go4retro/Nu6509/ref/6502 $B1.JPG

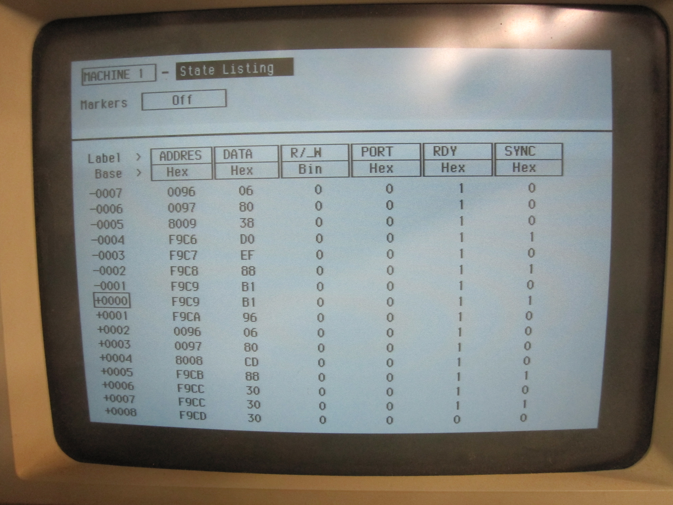
ref/6502 $B1.JPG
