go4retro/Nu6509/ref/65C02 $91.JPG

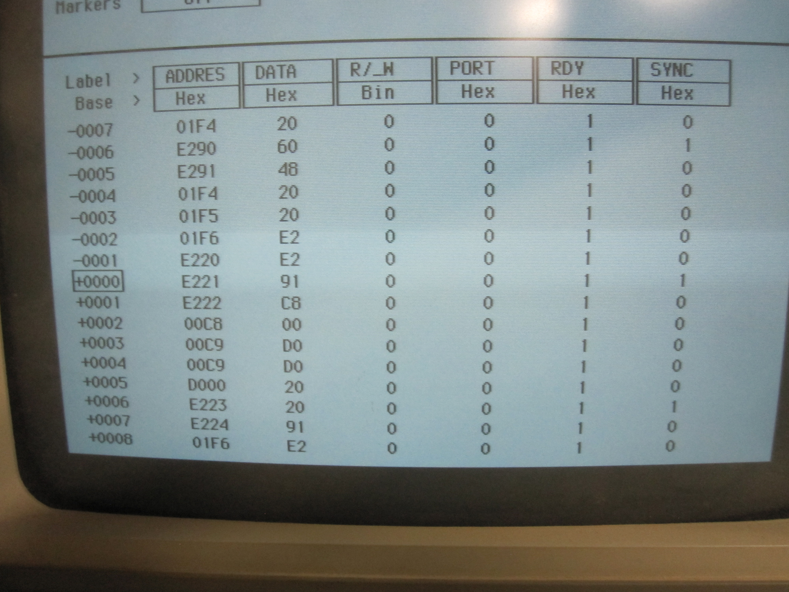
ref/65C02 $91.JPG
