go4retro/Nu6509/pcb/Nu6509 PCB v4.png

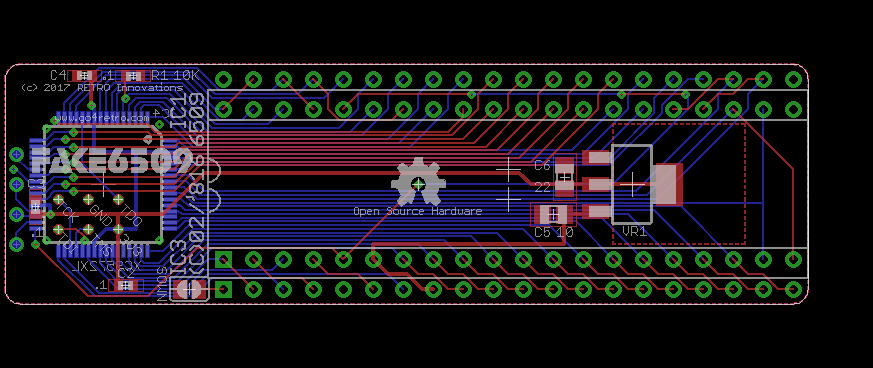
pcb/Nu6509 PCB v4.png
