go4retro/Nu6509/pcb/Nu6509_v3 PCB.png

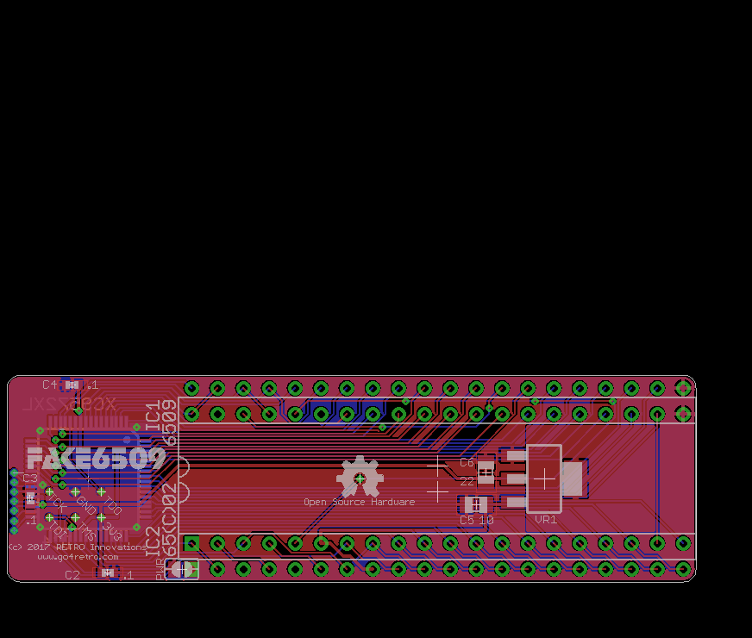
pcb/Nu6509_v3 PCB.png
