go4retro/Nu6509/pcb/Nu6509_v3 Schematic.png

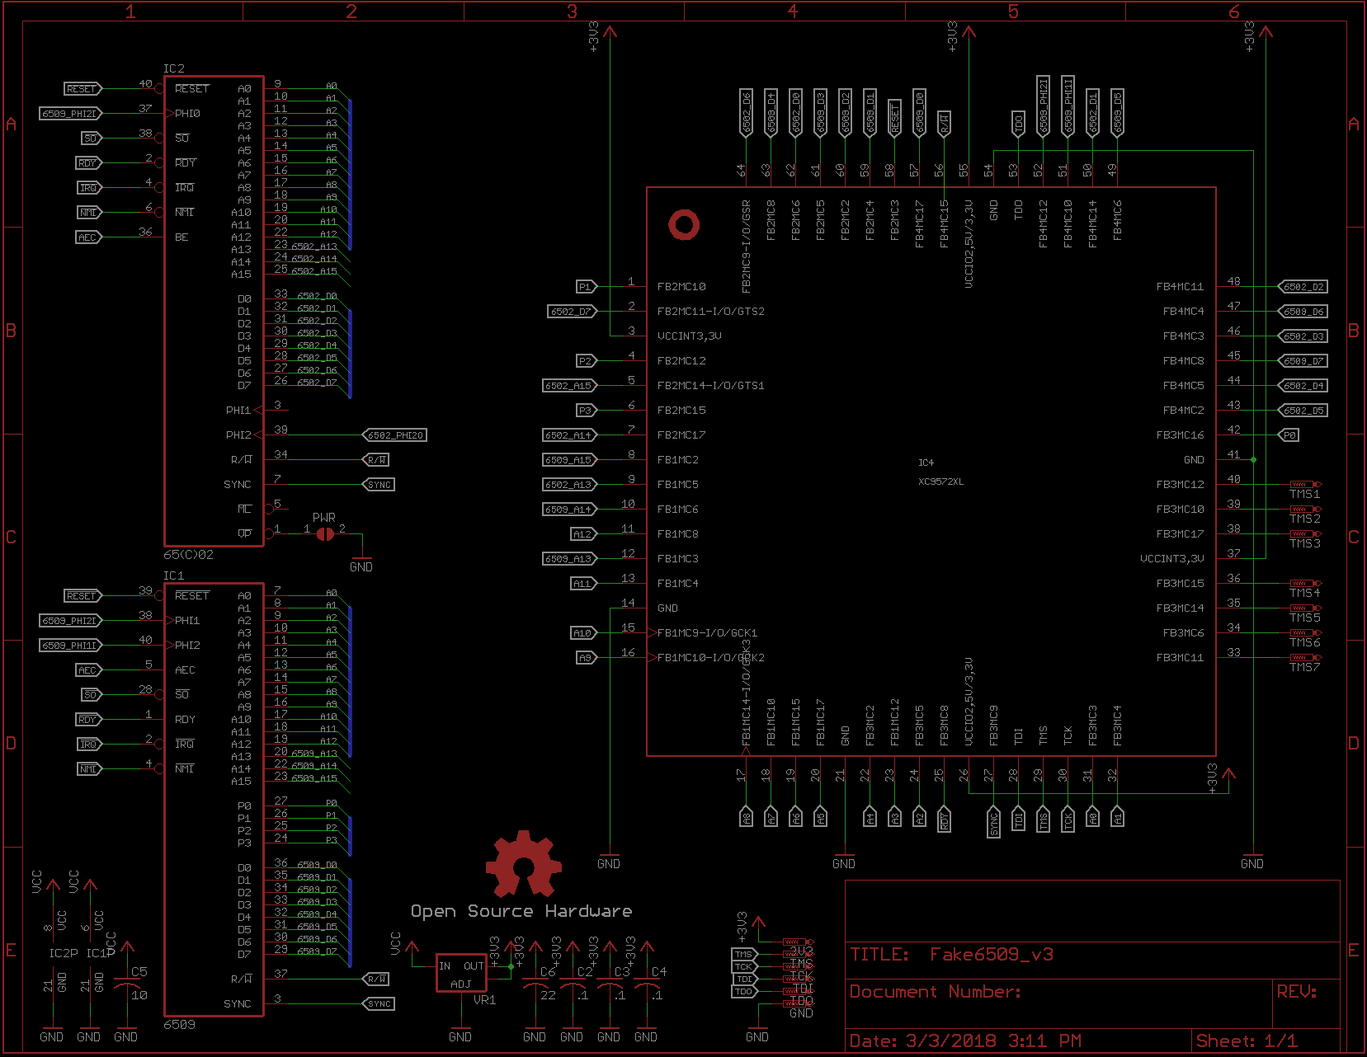
pcb/Nu6509_v3 Schematic.png
