go4retro/Nu6509/ref/65C02 $B1.JPG

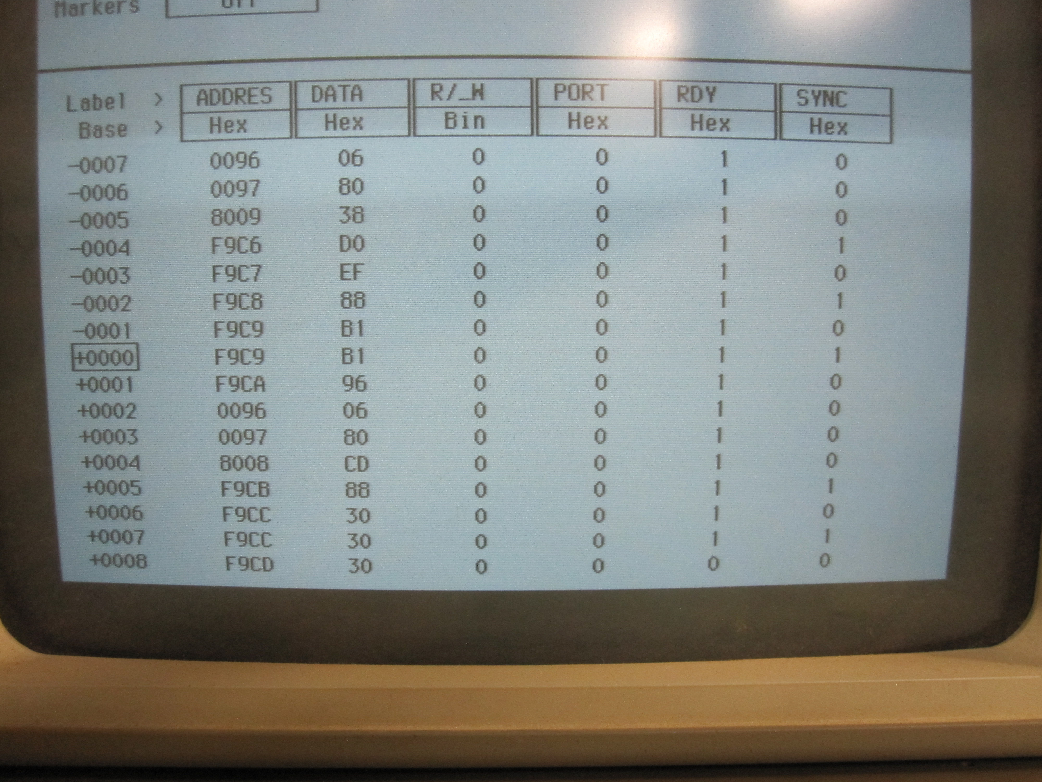
ref/65C02 $B1.JPG
