go4retro/Nu6509/pcb/Nu6509_v3 Schematic.pdf

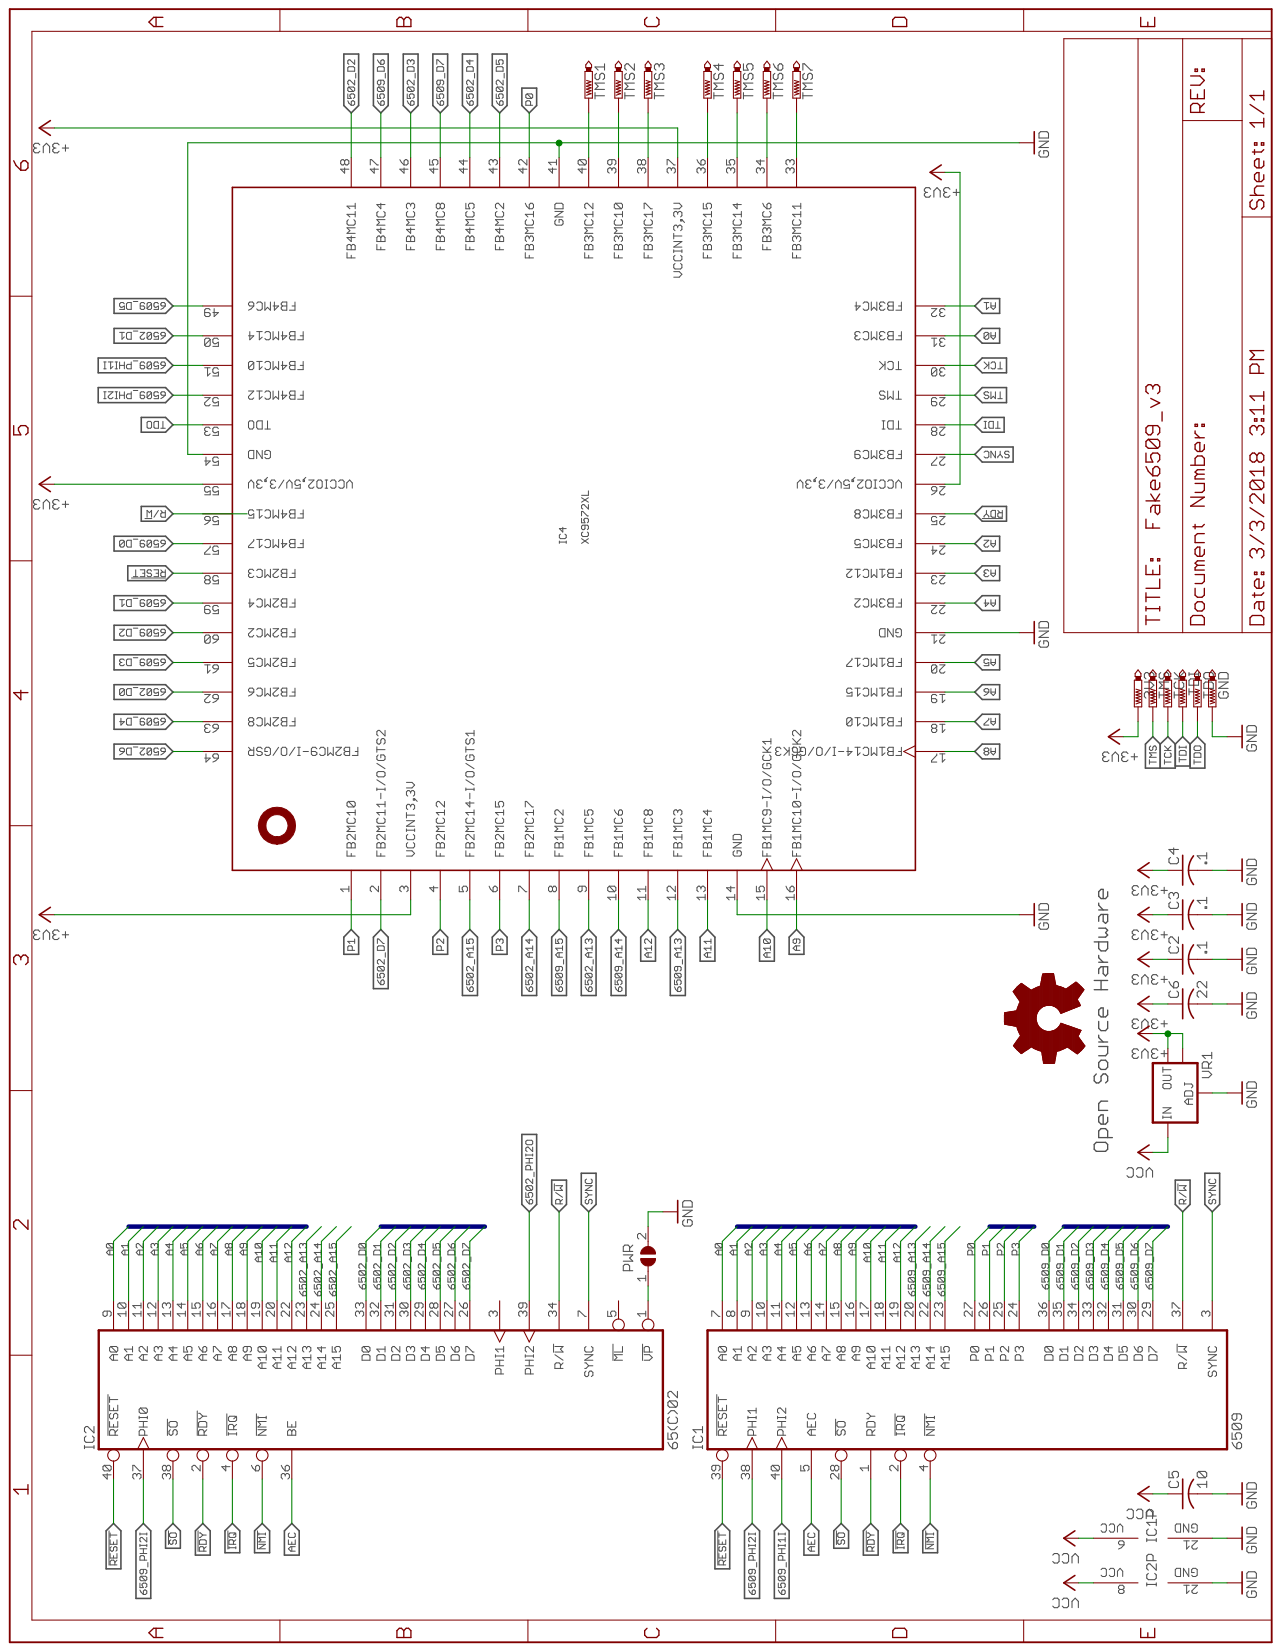
[picture p7: page 1]
