go4retro/Nu6509/pcb/Nu6509_v3 PCB.pdf

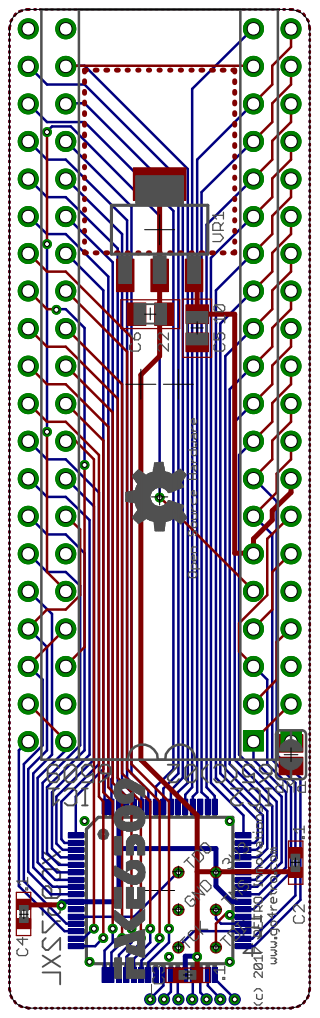
[picture p8: page 1]
