go4retro/Nu6509/pcb/Nu6509_v2 Schematic.pdf

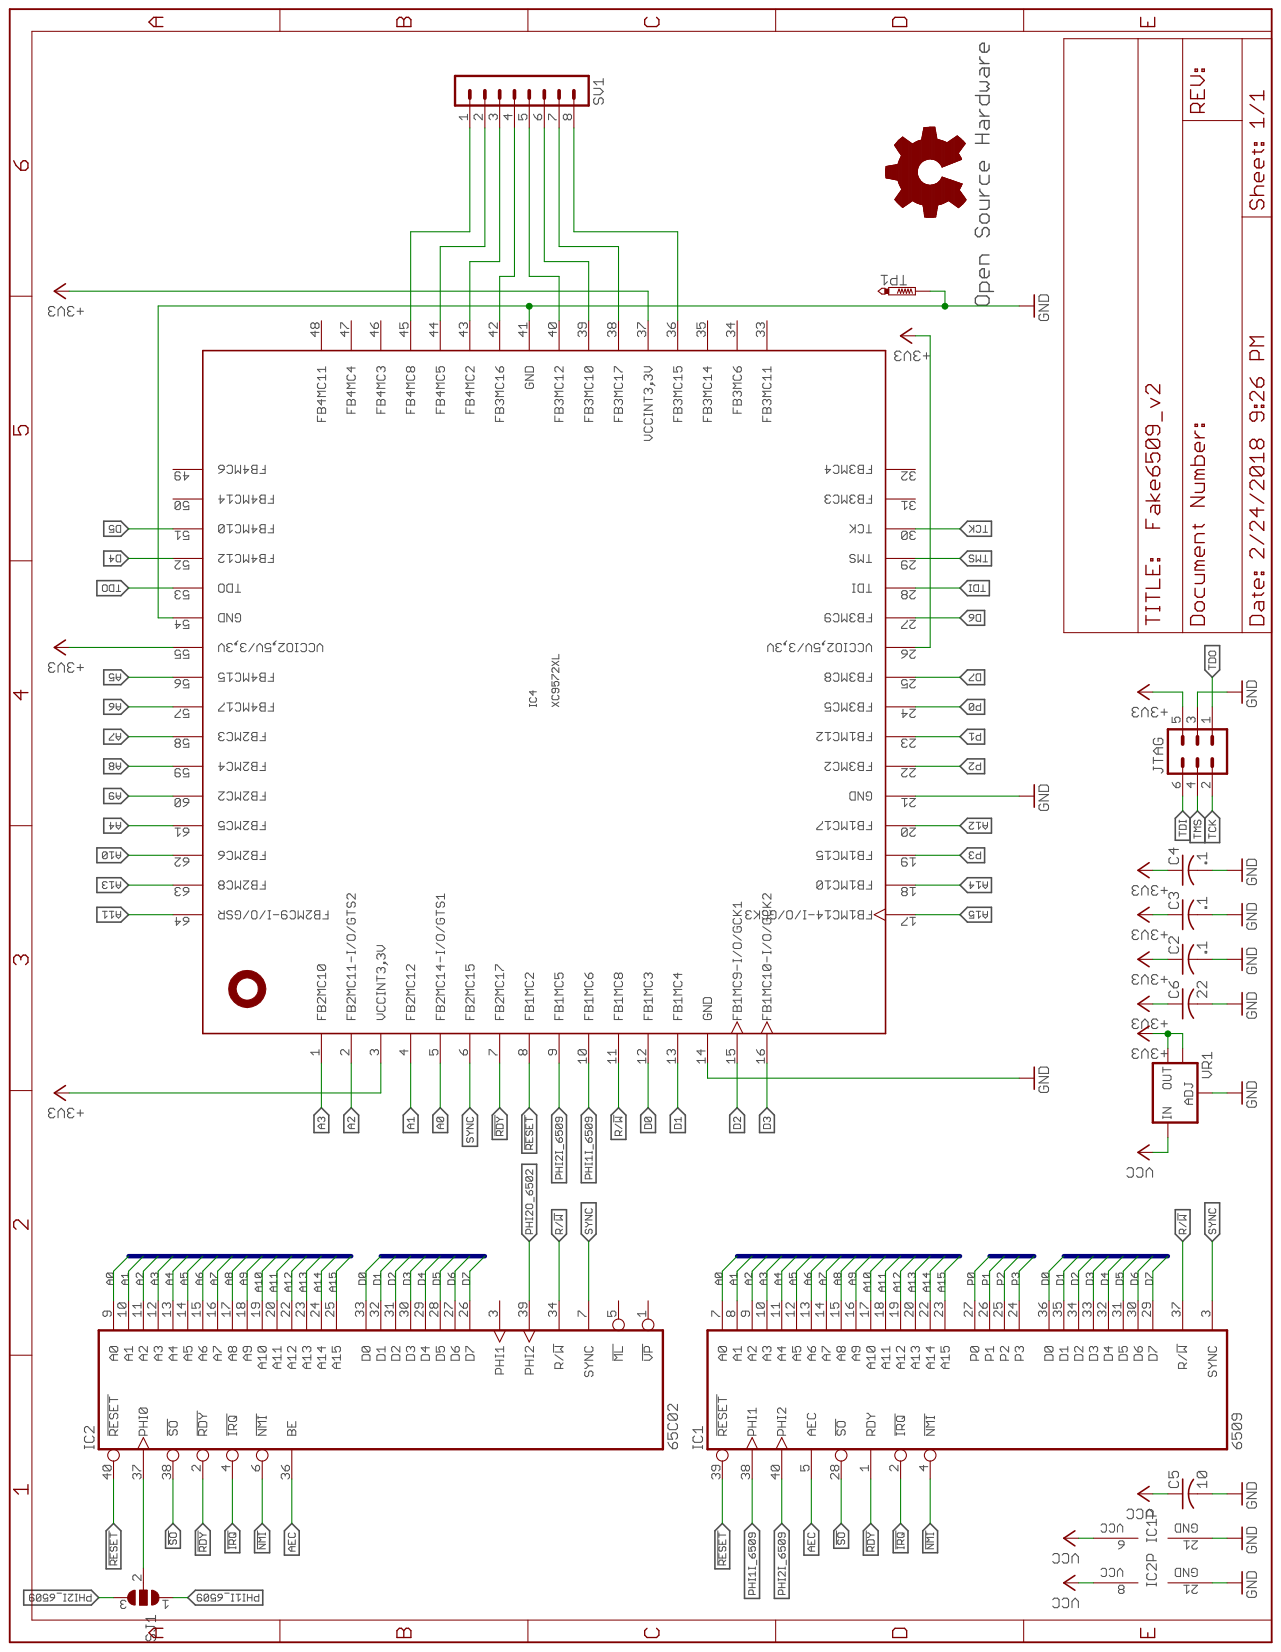
[picture p9: page 1]
