go4retro/Nu6509/pcb/Nu6509_v2 PCB.pdf

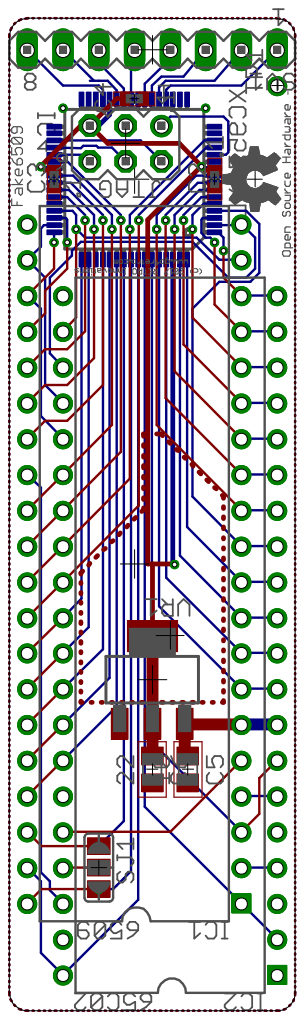
[picture p10: page 1]
