go4retro/Nu6509/pcb/Nu6509_v4.brd

## EAGLE design pcb/Nu6509_v4.brd (2020-04-17)

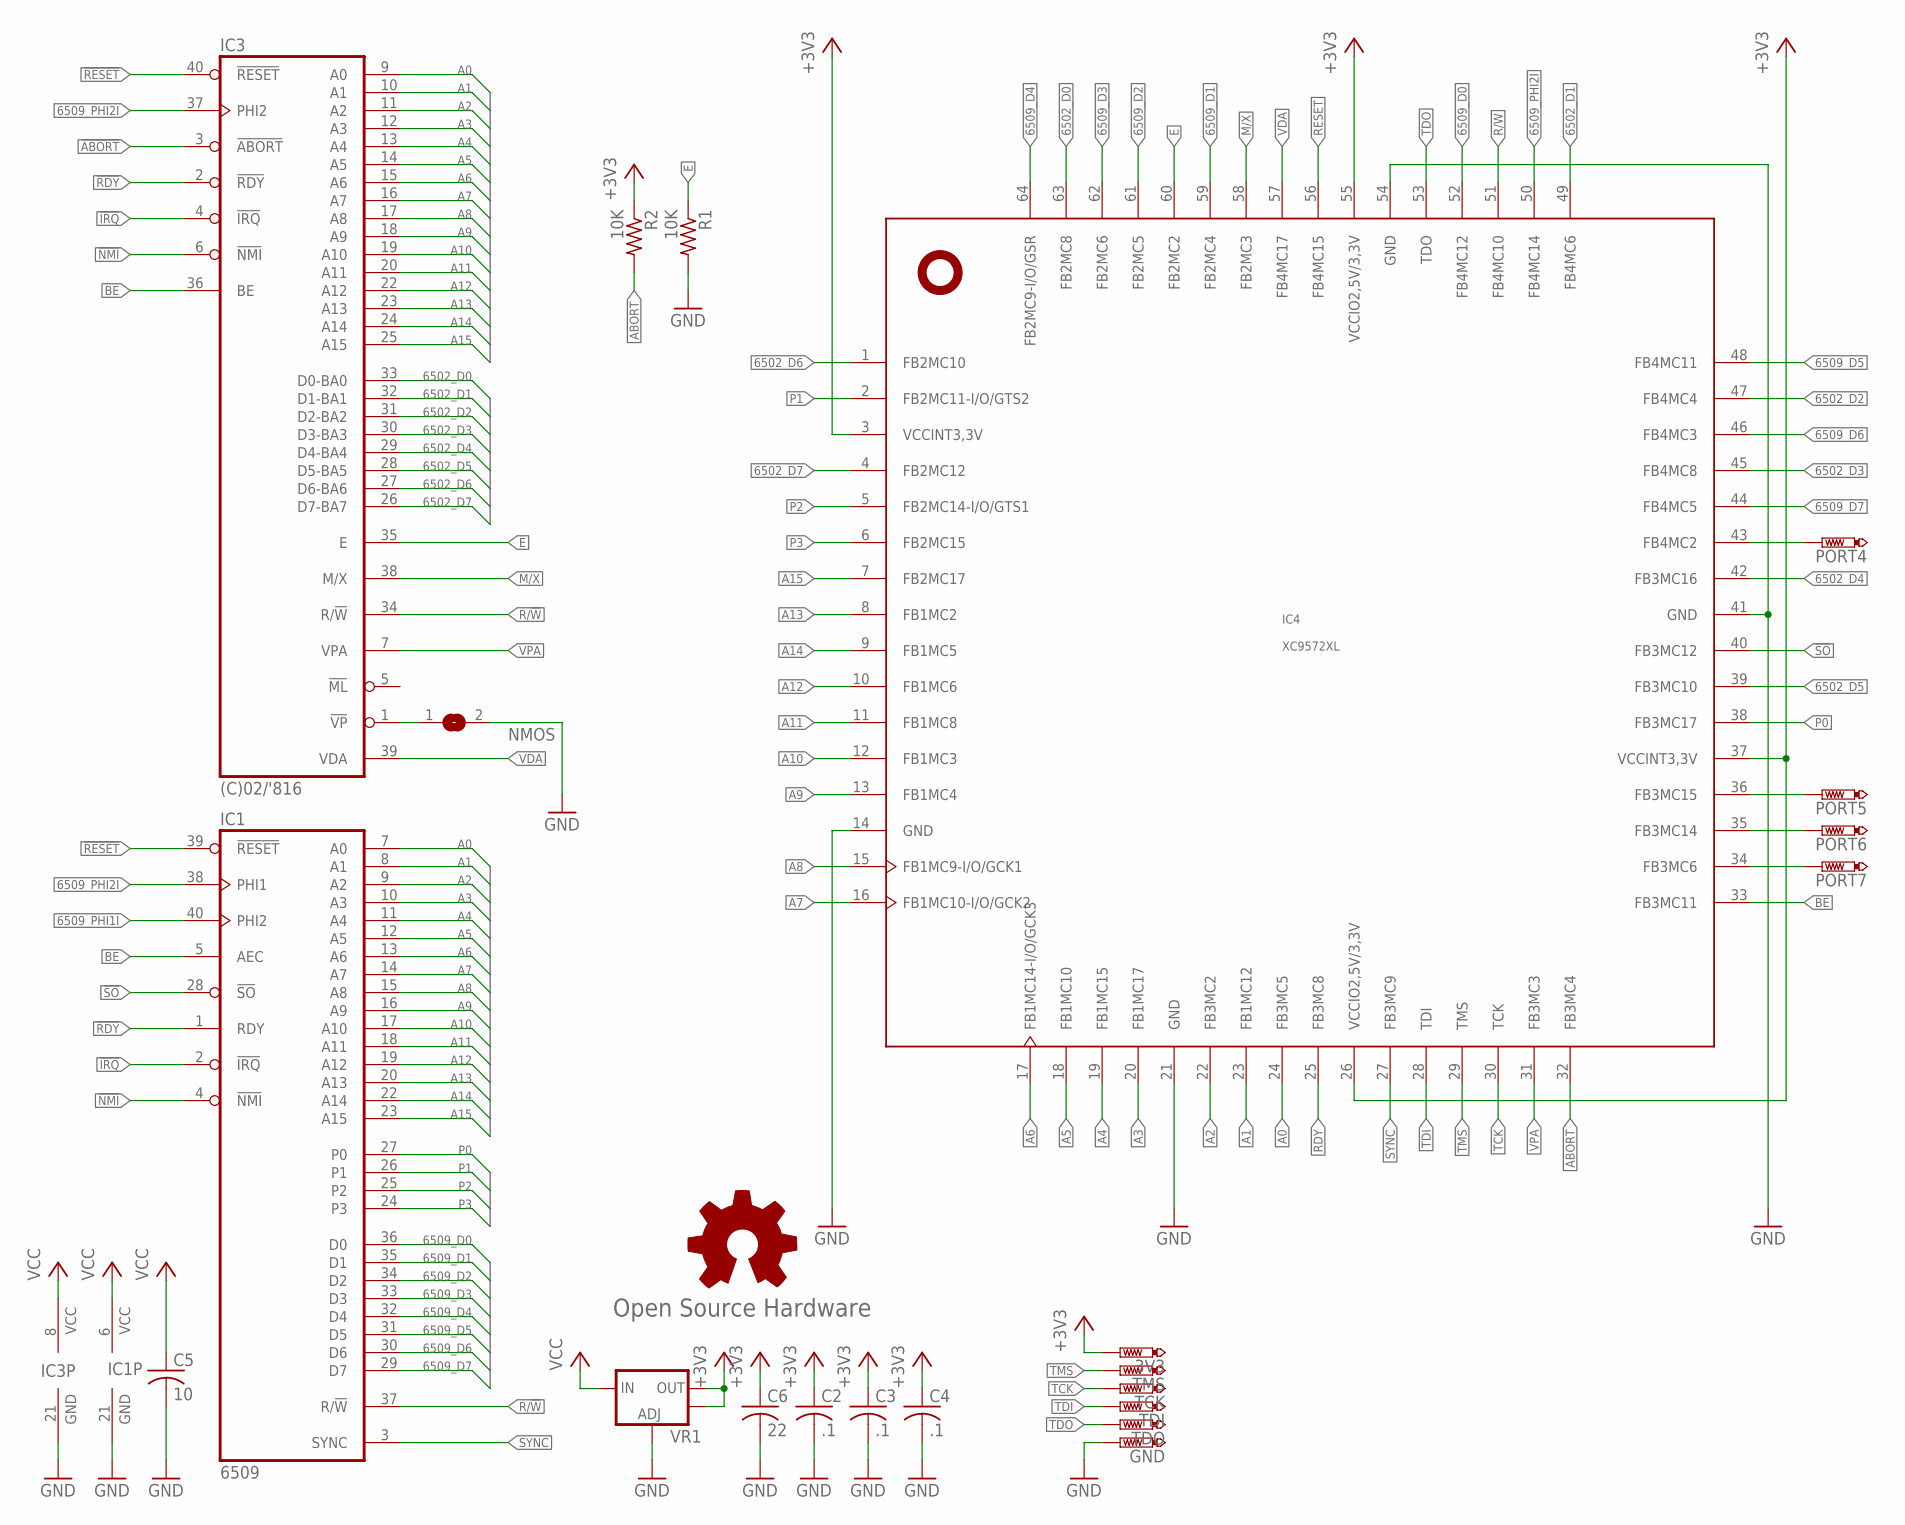
[picture p11: schematic Nu6509_v4.sch]

Parts:
3V3: PTR1TP08R; TP08R
C2, C3, C4: .1; C0402
C5: 10; C0805
C6: 22; C0805
GND: PTR1TP08R; TP08R
GOLD_ORB_SM1: Open Source Hardware; OSHW_5MM
IC1: 6509; DIL40-ROUNDPAD
IC3: (C)02/'816; DIL40-ROUNDPAD
IC4: XC9572XL; VQFP64
NMOS: SJ
PORT4, PORT5, PORT6, PORT7: PTR1TP08R; TP08R
R1, R2: 10K; R0402
TCK: PTR1TP08R; TP08R
TDI: PTR1TP08R; TP08R
TDO: PTR1TP08R; TP08R
TMS: PTR1TP08R; TP08R
VR1: V_REG_LM1117SOT223; SOT223

Connections:
6502_D0: IC3.33 (D0-BA0), IC4.63 (FB2MC8)
6502_D1: IC3.32 (D1-BA1), IC4.49 (FB4MC6)
6502_D2: IC3.31 (D2-BA2), IC4.47 (FB4MC4)
6502_D3: IC3.30 (D3-BA3), IC4.45 (FB4MC8)
6502_D4: IC3.29 (D4-BA4), IC4.42 (FB3MC16)
6502_D5: IC3.28 (D5-BA5), IC4.39 (FB3MC10)
6502_D6: IC3.27 (D6-BA6), IC4.1 (FB2MC10)
6502_D7: IC3.26 (D7-BA7), IC4.4 (FB2MC12)
6509_D0: IC1.36 (D0), IC4.52 (FB4MC12)
6509_D1: IC1.35 (D1), IC4.59 (FB2MC4)
6509_D2: IC1.34 (D2), IC4.61 (FB2MC5)
6509_D3: IC1.33 (D3), IC4.62 (FB2MC6)
6509_D4: IC1.32 (D4), IC4.64 (FB2MC9-I/O/GSR)
6509_D5: IC1.31 (D5), IC4.48 (FB4MC11)
6509_D6: IC1.30 (D6), IC4.46 (FB4MC3)
6509_D7: IC1.29 (D7), IC4.44 (FB4MC5)
6509_PHI1I: IC1.40 (PHI2)
6509_PHI2I: IC1.38 (PHI1), IC3.37 (PHI2), IC4.50 (FB4MC14)
!ABORT: IC3.3 (!ABORT), IC4.32 (FB3MC4), R2.2
!IRQ: IC1.2 (!IRQ), IC3.4 (!IRQ)
!NMI: IC1.4 (!NMI), IC3.6 (!NMI)
!RDY: IC1.1 (RDY), IC3.2 (!RDY), IC4.25 (FB3MC8)
!RESET: IC1.39 (!RESET), IC3.40 (!RESET), IC4.56 (FB4MC15)
!SO: IC1.28 (!SO), IC4.40 (FB3MC12)
+3V3: 3V3.TP, C2.1, C3.1, C4.1, C6.1, IC4.3 (VCCINT3,3V), IC4.26 (VCCIO2,5V/3,3V), IC4.37 (VCCINT3,3V), IC4.55 (VCCIO2,5V/3,3V), R2.1, VR1.2 (OUT), VR1.4 (OUT)
A0: IC1.7 (A0), IC3.9 (A0), IC4.24 (FB3MC5)
A1: IC1.8 (A1), IC3.10 (A1), IC4.23 (FB1MC12)
A2: IC1.9 (A2), IC3.11 (A2), IC4.22 (FB3MC2)
A3: IC1.10 (A3), IC3.12 (A3), IC4.20 (FB1MC17)
A4: IC1.11 (A4), IC3.13 (A4), IC4.19 (FB1MC15)
A5: IC1.12 (A5), IC3.14 (A5), IC4.18 (FB1MC10)
A6: IC1.13 (A6), IC3.15 (A6), IC4.17 (FB1MC14-I/O/GCK3)
A7: IC1.14 (A7), IC3.16 (A7), IC4.16 (FB1MC10-I/O/GCK2)
A8: IC1.15 (A8), IC3.17 (A8), IC4.15 (FB1MC9-I/O/GCK1)
A9: IC1.16 (A9), IC3.18 (A9), IC4.13 (FB1MC4)
A10: IC1.17 (A10), IC3.19 (A10), IC4.12 (FB1MC3)
A11: IC1.18 (A11), IC3.20 (A11), IC4.11 (FB1MC8)
A12: IC1.19 (A12), IC3.22 (A12), IC4.10 (FB1MC6)
A13: IC1.20 (A13), IC3.23 (A13), IC4.8 (FB1MC2)
A14: IC1.22 (A14), IC3.24 (A14), IC4.9 (FB1MC5)
A15: IC1.23 (A15), IC3.25 (A15), IC4.7 (FB2MC17)
BE: IC1.5 (AEC), IC3.36 (BE), IC4.33 (FB3MC11)
E: IC3.35 (E), IC4.60 (FB2MC2), R1.1
GND: C2.2, C3.2, C4.2, C5.2, C6.2, GND.TP, IC1.21 (GND), IC3.21 (GND), IC4.14 (GND), IC4.21 (GND), IC4.41 (GND), IC4.54 (GND), NMOS.2, R1.2, VR1.1 (ADJ)
M/X: IC3.38 (M/X), IC4.58 (FB2MC3)
unnamed: IC3.1 (!VP), NMOS.1
P0: IC1.27 (P0), IC4.38 (FB3MC17)
P1: IC1.26 (P1), IC4.2 (FB2MC11-I/O/GTS2)
P2: IC1.25 (P2), IC4.5 (FB2MC14-I/O/GTS1)
P3: IC1.24 (P3), IC4.6 (FB2MC15)
PORT4: IC4.43 (FB4MC2), PORT4.TP
PORT5: IC4.36 (FB3MC15), PORT5.TP
PORT6: IC4.35 (FB3MC14), PORT6.TP
PORT7: IC4.34 (FB3MC6), PORT7.TP
R/!W: IC1.37 (R/!W), IC3.34 (R/!W), IC4.51 (FB4MC10)
SYNC: IC1.3 (SYNC), IC4.27 (FB3MC9)
TCK: IC4.30 (TCK), TCK.TP
TDI: IC4.28 (TDI), TDI.TP
TDO: IC4.53 (TDO), TDO.TP
TMS: IC4.29 (TMS), TMS.TP
VCC: C5.1, IC1.6 (VCC), IC3.8 (VCC), VR1.3 (IN)
VDA: IC3.39 (VDA), IC4.57 (FB4MC17)
VPA: IC3.7 (VPA), IC4.31 (FB3MC3)

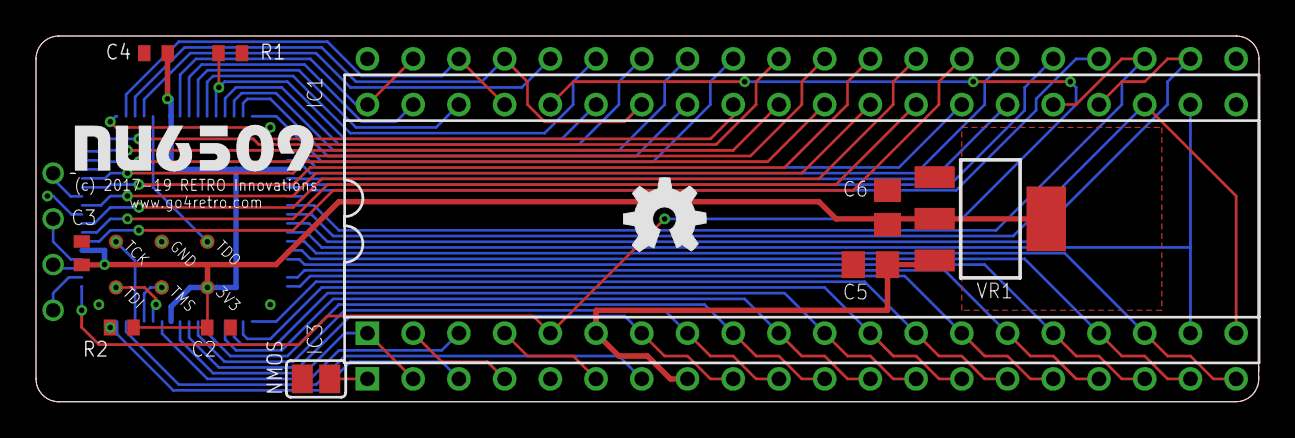
[picture p12: board Nu6509_v4.brd from above]

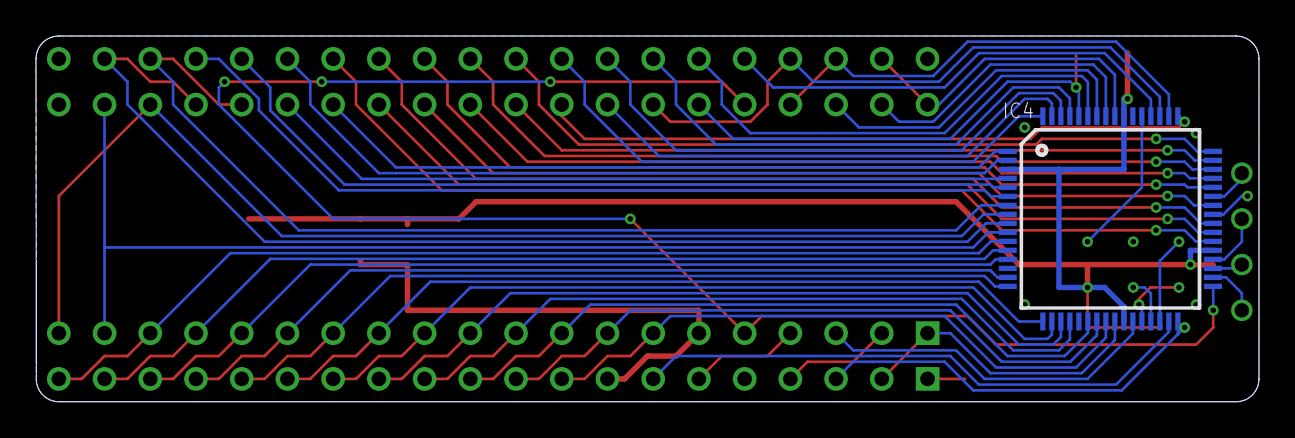
[picture p13: board Nu6509_v4.brd from below]

Board: 2 copper layers, 67.9 x 20.3 mm, 23 parts (5 on the bottom side), 62 nets.
