go4retro/Nu6509/pcb/Nu6509_v3.brd

## EAGLE design pcb/Nu6509_v3.brd (2018-07-28, an earlier design)

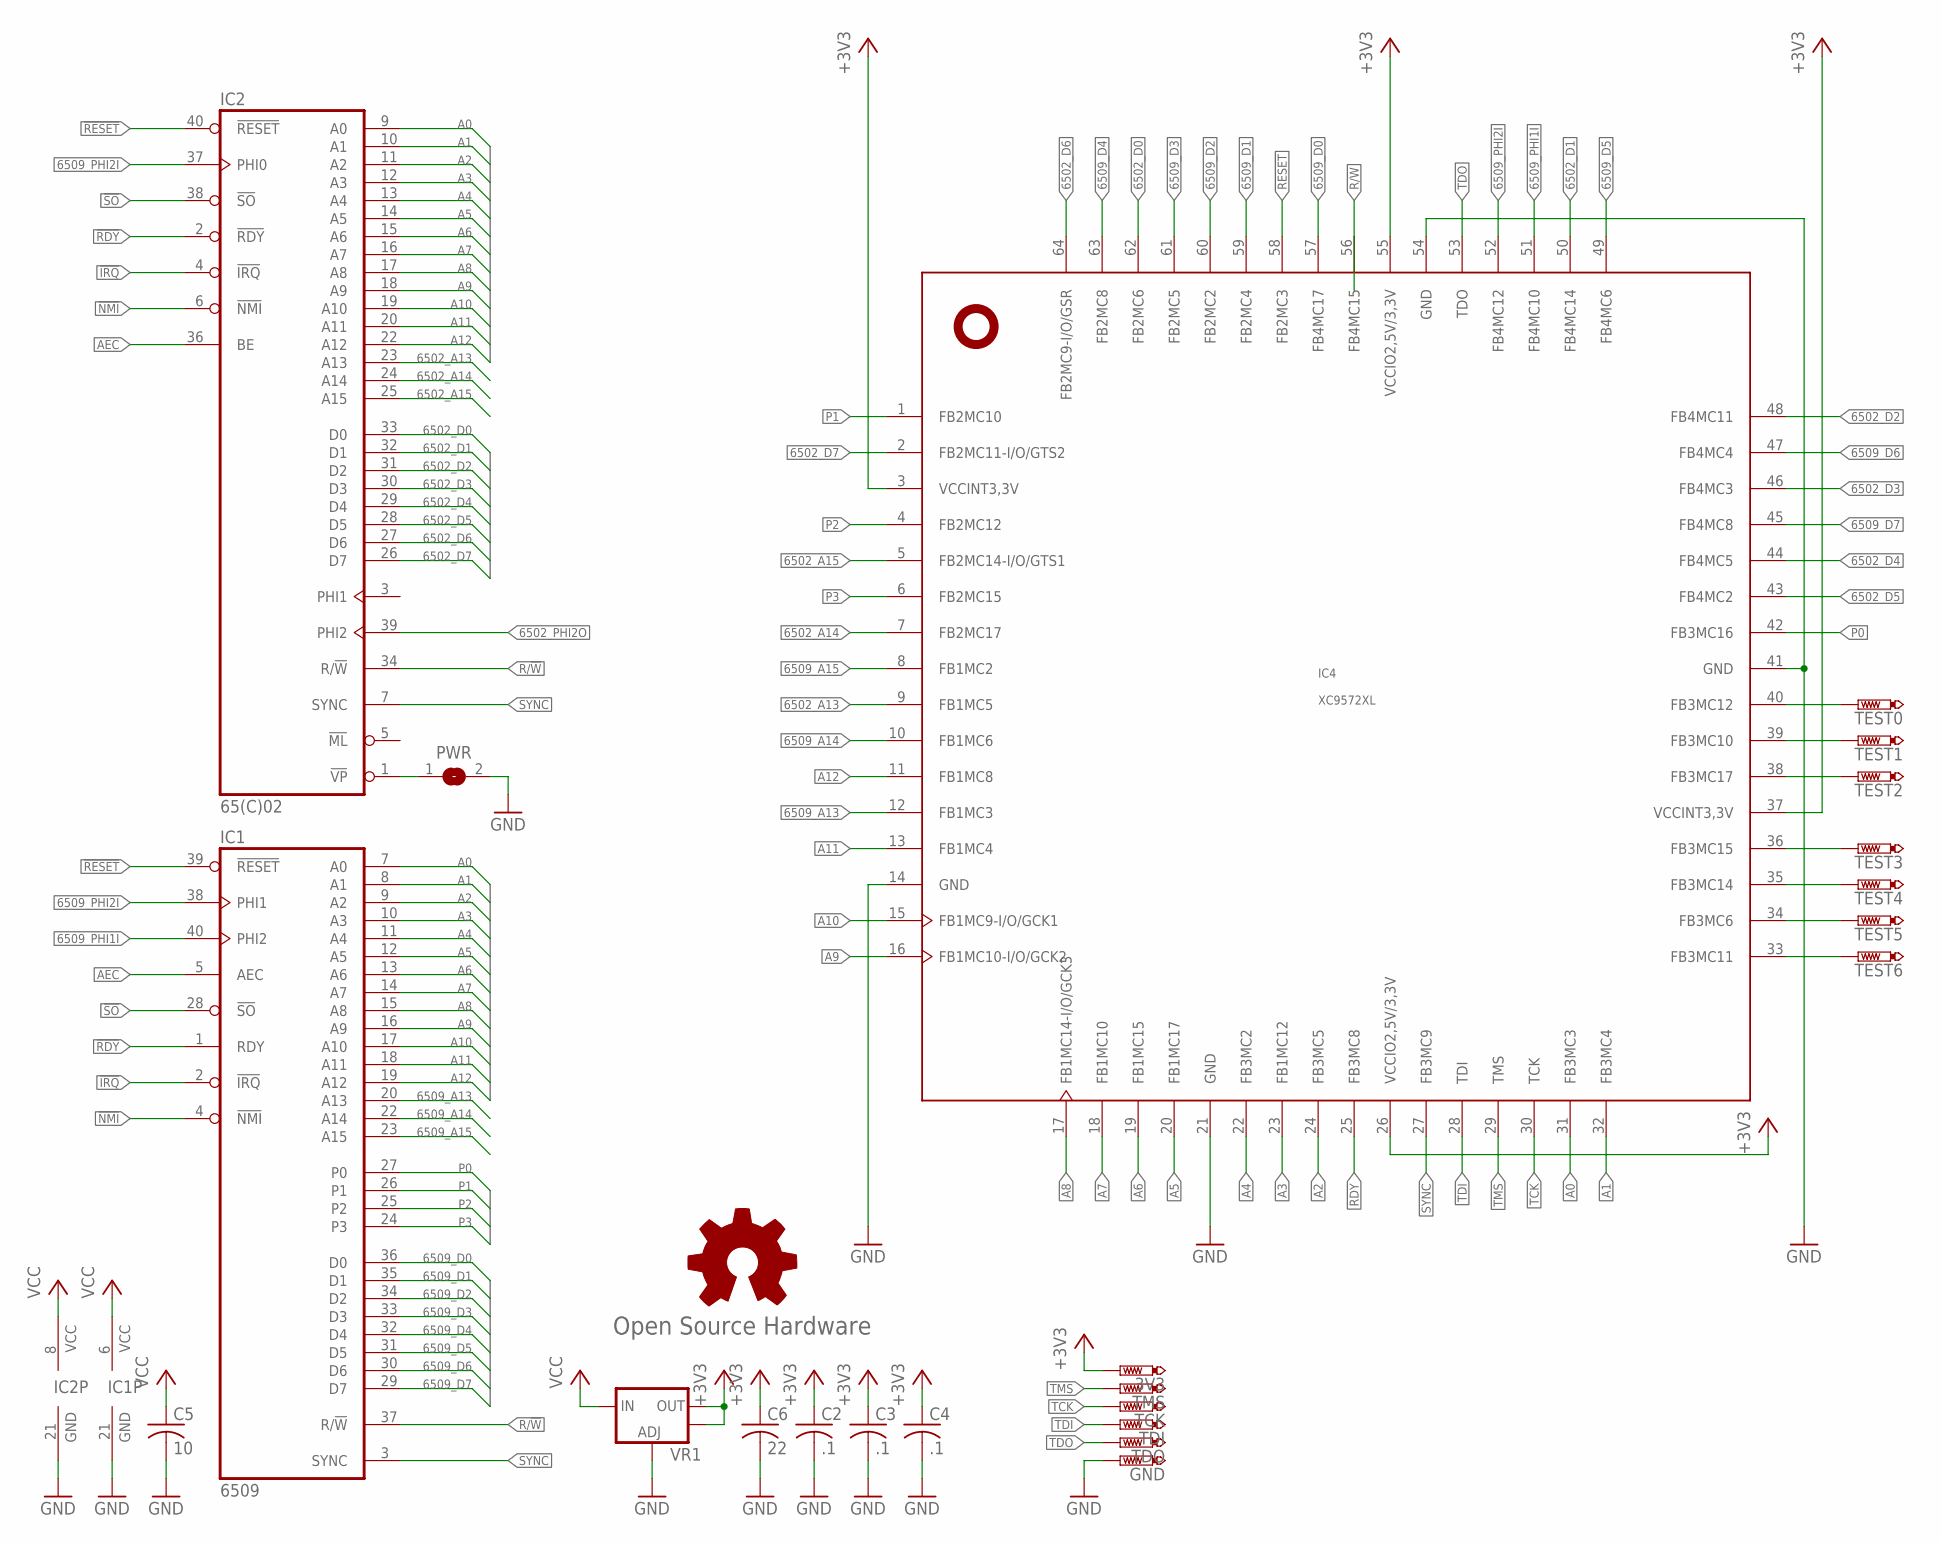
[picture p14: schematic Nu6509_v3.sch]

Parts:
3V3: PTR1TP08R; TP08R
C2, C3, C4: .1; C0402
C5: 10; C0805
C6: 22; C0805
GND: PTR1TP08R; TP08R
GOLD_ORB_SM1: Open Source Hardware; OSHW_5MM
IC1: 6509; DIL40-ROUNDPAD
IC2: 65(C)02; DIL40-ROUNDPAD
IC4: XC9572XL; VQFP64
PWR: SJ
TCK: PTR1TP08R; TP08R
TDI: PTR1TP08R; TP08R
TDO: PTR1TP08R; TP08R
TEST0, TEST1, TEST2, TEST3, TEST4, TEST5, TEST6: PTR1TP08R; TP08R
TMS: PTR1TP08R; TP08R
VR1: V_REG_LM1117SOT223; SOT223

Connections:
6502_A13: IC2.23 (A13), IC4.9 (FB1MC5)
6502_A14: IC2.24 (A14), IC4.7 (FB2MC17)
6502_A15: IC2.25 (A15), IC4.5 (FB2MC14-I/O/GTS1)
6502_D0: IC2.33 (D0), IC4.62 (FB2MC6)
6502_D1: IC2.32 (D1), IC4.50 (FB4MC14)
6502_D2: IC2.31 (D2), IC4.48 (FB4MC11)
6502_D3: IC2.30 (D3), IC4.46 (FB4MC3)
6502_D4: IC2.29 (D4), IC4.44 (FB4MC5)
6502_D5: IC2.28 (D5), IC4.43 (FB4MC2)
6502_D6: IC2.27 (D6), IC4.64 (FB2MC9-I/O/GSR)
6502_D7: IC2.26 (D7), IC4.2 (FB2MC11-I/O/GTS2)
6502_PHI2O: IC2.39 (PHI2)
6509_A13: IC1.20 (A13), IC4.12 (FB1MC3)
6509_A14: IC1.22 (A14), IC4.10 (FB1MC6)
6509_A15: IC1.23 (A15), IC4.8 (FB1MC2)
6509_D0: IC1.36 (D0), IC4.57 (FB4MC17)
6509_D1: IC1.35 (D1), IC4.59 (FB2MC4)
6509_D2: IC1.34 (D2), IC4.60 (FB2MC2)
6509_D3: IC1.33 (D3), IC4.61 (FB2MC5)
6509_D4: IC1.32 (D4), IC4.63 (FB2MC8)
6509_D5: IC1.31 (D5), IC4.49 (FB4MC6)
6509_D6: IC1.30 (D6), IC4.47 (FB4MC4)
6509_D7: IC1.29 (D7), IC4.45 (FB4MC8)
6509_PHI1I: IC1.40 (PHI2), IC4.51 (FB4MC10)
6509_PHI2I: IC1.38 (PHI1), IC2.37 (PHI0), IC4.52 (FB4MC12)
!IRQ: IC1.2 (!IRQ), IC2.4 (!IRQ)
!NMI: IC1.4 (!NMI), IC2.6 (!NMI)
!RDY: IC1.1 (RDY), IC2.2 (!RDY), IC4.25 (FB3MC8)
!RESET: IC1.39 (!RESET), IC2.40 (!RESET), IC4.58 (FB2MC3)
!SO: IC1.28 (!SO), IC2.38 (!SO)
+3V3: 3V3.TP, C2.1, C3.1, C4.1, C6.1, IC4.3 (VCCINT3,3V), IC4.26 (VCCIO2,5V/3,3V), IC4.37 (VCCINT3,3V), IC4.55 (VCCIO2,5V/3,3V), VR1.2 (OUT), VR1.4 (OUT)
A0: IC1.7 (A0), IC2.9 (A0), IC4.31 (FB3MC3)
A1: IC1.8 (A1), IC2.10 (A1), IC4.32 (FB3MC4)
A2: IC1.9 (A2), IC2.11 (A2), IC4.24 (FB3MC5)
A3: IC1.10 (A3), IC2.12 (A3), IC4.23 (FB1MC12)
A4: IC1.11 (A4), IC2.13 (A4), IC4.22 (FB3MC2)
A5: IC1.12 (A5), IC2.14 (A5), IC4.20 (FB1MC17)
A6: IC1.13 (A6), IC2.15 (A6), IC4.19 (FB1MC15)
A7: IC1.14 (A7), IC2.16 (A7), IC4.18 (FB1MC10)
A8: IC1.15 (A8), IC2.17 (A8), IC4.17 (FB1MC14-I/O/GCK3)
A9: IC1.16 (A9), IC2.18 (A9), IC4.16 (FB1MC10-I/O/GCK2)
A10: IC1.17 (A10), IC2.19 (A10), IC4.15 (FB1MC9-I/O/GCK1)
A11: IC1.18 (A11), IC2.20 (A11), IC4.13 (FB1MC4)
A12: IC1.19 (A12), IC2.22 (A12), IC4.11 (FB1MC8)
AEC: IC1.5 (AEC), IC2.36 (BE)
GND: C2.2, C3.2, C4.2, C5.2, C6.2, GND.TP, IC1.21 (GND), IC2.21 (GND), IC4.14 (GND), IC4.21 (GND), IC4.41 (GND), IC4.54 (GND), PWR.2, VR1.1 (ADJ)
unnamed: IC2.1 (!VP), PWR.1
P0: IC1.27 (P0), IC4.42 (FB3MC16)
P1: IC1.26 (P1), IC4.1 (FB2MC10)
P2: IC1.25 (P2), IC4.4 (FB2MC12)
P3: IC1.24 (P3), IC4.6 (FB2MC15)
R/!W: IC1.37 (R/!W), IC2.34 (R/!W), IC4.56 (FB4MC15)
SYNC: IC1.3 (SYNC), IC2.7 (SYNC), IC4.27 (FB3MC9)
TCK: IC4.30 (TCK), TCK.TP
TDI: IC4.28 (TDI), TDI.TP
TDO: IC4.53 (TDO), TDO.TP
TEST0: IC4.40 (FB3MC12), TEST0.TP
TEST1: IC4.39 (FB3MC10), TEST1.TP
TEST2: IC4.38 (FB3MC17), TEST2.TP
TEST3: IC4.36 (FB3MC15), TEST3.TP
TEST4: IC4.35 (FB3MC14), TEST4.TP
TEST5: IC4.34 (FB3MC6), TEST5.TP
TEST6: IC4.33 (FB3MC11), TEST6.TP
TMS: IC4.29 (TMS), TMS.TP
VCC: C5.1, IC1.6 (VCC), IC2.8 (VCC), VR1.3 (IN)

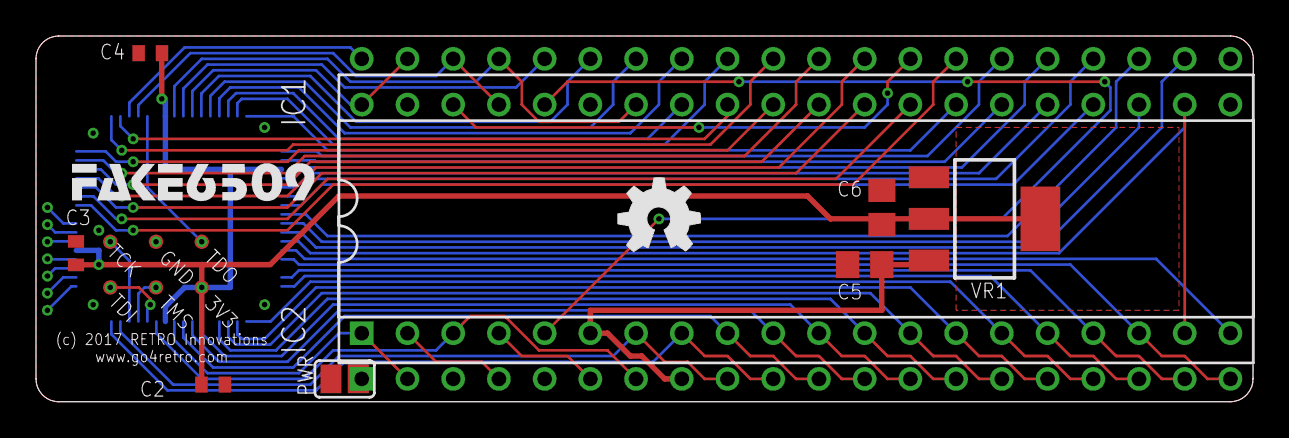
[picture p15: board Nu6509_v3.brd from above]

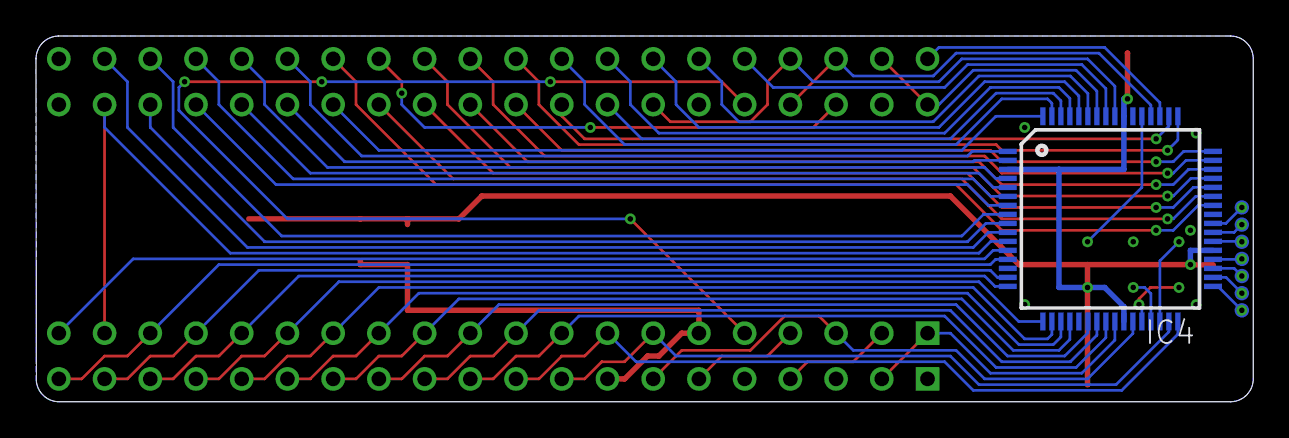
[picture p16: board Nu6509_v3.brd from below]

Board: 2 copper layers, 67.6 x 20.3 mm, 24 parts (8 on the bottom side), 64 nets.
