go4retro/Nu6509/pcb/Nu6509_test.brd

## EAGLE design pcb/Nu6509_test.brd (continued)

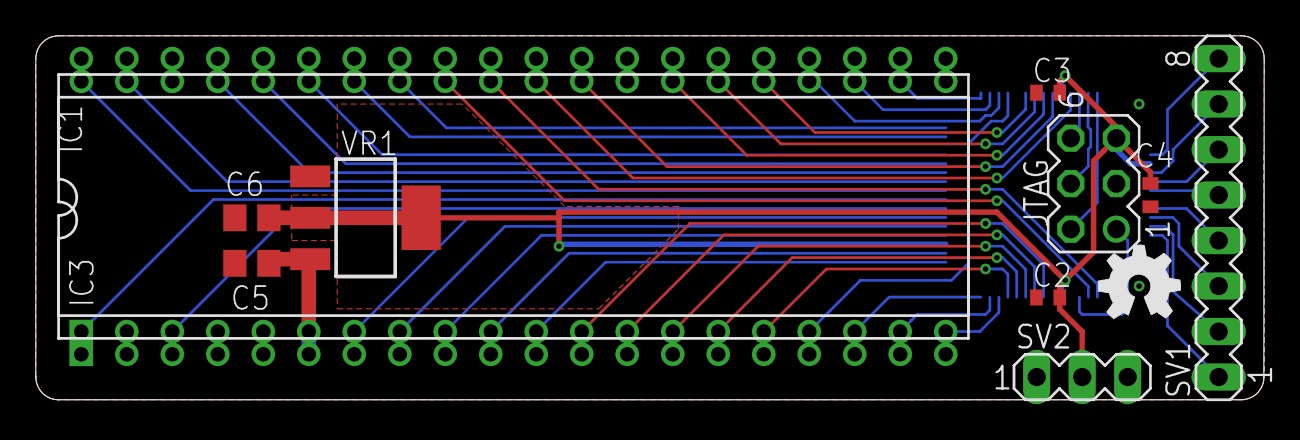
[picture p20: board Nu6509_test.brd from above]

Board: 2 copper layers, 68.6 x 20.3 mm, 13 parts (1 on the bottom side), 53 nets.
