go4retro/Nu6509/(commit log)

2018-02-21 Added Flowerbox to Fask6509.v
2018-02-24 Added comments to Verilog and cleaned up a small bug in the PCB
    [Fake6509_v2.brd, Fake6509_v2.sch]
2018-02-25 More changes to Verilog and PCB cleanup
    [Fake6509_v2.brd, Fake6509_v2.sch]
2018-02-25 Added PDFs of Schematic and PCB
2018-03-03 Created v3 of PCB
    [Fake6509_v3.brd, Fake6509_v3.sch]
2018-06-29 v3 HDL
    [Fake6509_v3.brd]
2018-06-29 Added traces for Rockwell 65C02
2018-06-29 NMOS 6502 Traces
2018-07-28 Modify PCB and Verilog to support both '02 and '816
    [Fake6509_v4.brd, Fake6509_v4.sch]
2019-04-19 Disabled writes to $0 and $1 when in 816 native mode and fixed copyright notice
    [Fak6509.v]
2019-12-05 Switch name to Nu6509
    [Nu6509_test.brd, Nu6509_test.sch, Nu6509_v2.brd, Nu6509_v2.sch, Nu6509_v3.brd, Nu6509_v3.sch, Nu6509_v4.brd, Nu6509_v4.sch]
2020-04-17 Added JED file
    [Nu6509_v4.brd]
