go4retro/Nu6509/(notices)

Notices in the files:
pcb/Nu6509_v4.brd:
(c) 2017-19 RETRO Innovations
pcb/Fake6509_v4.brd:
(c) 2017 RETRO Innovations
parts and their libraries:
SparkFun: Licensing: CC v3.0 Share-Alike You are welcome to use this library for commercial purposes.
